JohmasJo/OptiDodge/PCB And Shell/OptiDodge_PCB/BOM_Board1_PCB1_2026-10-20.xlsx

Quantity | Designator | Footprint | Value | Manufacturer Part | Manufacturer | Supplier Part | Supplier
3 | C1,C3,C5 | C0603 | 100nF
2 | C2,C4 | C0603 | 10uF
4 | KEY1,KEY2,KEY3,KEY4 | SW-SMD_L3.9-W3.0-P4.45 |  | TS-1088-AR02016 | XUNPU(讯普) | C720477 | LCSC
1 | LED1 | LED0603-FD |  | GL0603UR01 | Guiguang light(桂光光电) | C51933292 | LCSC
1 | R1 | R0603 | 33
4 | R2,R3,R4,R5 | R0603 | 10K
1 | U1 | LED-TH_BD5.8-P2.54-R-RD |  | HSDL-4261 | LITEON(光宝) | C5175315 | LCSC
1 | U2 | DIP-8，非标错位直插，脚距 2.00 mm
1 | U3 | SOIC-8_L5.2-W5.2-P1.27-LS8.0-BL |  | W25Q64JVSSIM | Winbond(华邦) | C5362615 | LCSC
1 | U4 | CONN-TH_L53.3-W22.9_STM32F103C8T6-CARD |  | LCKFB-DKX-STM32F103C8T6 | 立创开发板 | C22396880 | LCSC
1 | U5 | HDR-TH_LAIL-PM2.54-6P-L |  | LAIL-PM2.54-6P-L | LAILAN(莱联) | C54973826 | LCSC
1 | U6 | PowerSource 8Pin
