JohmasJo/OptiDodge/PCB And Shell/OptiDodge.SLDPRT

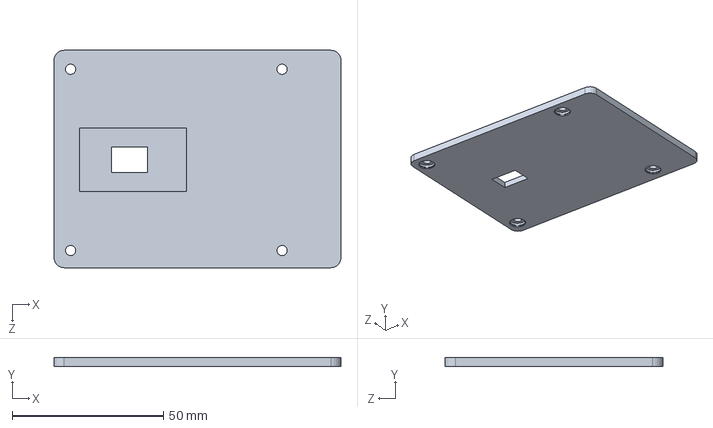
[picture p4: CAD file, 2026-10-26]
PCB And Shell/OptiDodge.SLDPRT
95.0 x 3.00 x 72.0 mm
