JohmasJo/OptiDodge/(list of files, cad)

Other CAD files:
PCB And Shell/OptiDodge.STL
