JohmasJo/OptiDodge/OptiDodge/Core/Inc/main.h

#define LED_TEST_Pin GPIO_PIN_1
#define LED_TEST_GPIO_Port GPIOA
#define OLED_RESET_Pin GPIO_PIN_2
#define OLED_RESET_GPIO_Port GPIOA
#define OLED_COMMAND_Pin GPIO_PIN_3
#define OLED_COMMAND_GPIO_Port GPIOA
#define PAW3327_NCS_Pin GPIO_PIN_8
#define PAW3327_NCS_GPIO_Port GPIOA
#define W25Q64_NCS_Pin GPIO_PIN_9
#define W25Q64_NCS_GPIO_Port GPIOA
#define MOUSE_MOTION_Pin GPIO_PIN_10
#define MOUSE_MOTION_GPIO_Port GPIOA
#define KEY1_Pin GPIO_PIN_3
#define KEY1_GPIO_Port GPIOB
#define KEY2_Pin GPIO_PIN_4
#define KEY2_GPIO_Port GPIOB
#define KEY3_Pin GPIO_PIN_5
#define KEY3_GPIO_Port GPIOB
#define KEY4_Pin GPIO_PIN_6
#define KEY4_GPIO_Port GPIOB
