JohmasJo/OptiDodge/OptiDodge/System/Game.c

//
// Created by wangy on 2026/10/24.
//

/* Includes */
#include "stm32f1xx_hal.h"
#include <stdlib.h>
#include "Draw.h"
#include "Game.h"
#include "Pattern.h"

/* Varieties */

/* Structure */

typedef struct {
    int8_t inward;   // 朝屏幕内部的速度，必须 > 0
    int8_t along;    // 沿出生边移动的速度
} Ball_Velocity;



/*
 * 每项都满足：
 * inward > 0
 * 1 <= inward² + along² <= 9
 */
static const Ball_Velocity Velocity_Table[] = {
    {1, -2}, {1, -1},
    {1,  0},
    {1,  1}, {1,  2},

    {2, -2}, {2, -1},
    {2,  0},
    {2,  1}, {2,  2},

    {3,  0}
};

/*enum*/
typedef enum{left, right, up, down} Side;


/* Functions*/
/**
 * @brief 输入小球和玩家信息，以计算是否会发生碰撞
 * @param ball 单个小球的结构体
 * @param player 玩家数据结构体
 * @return 玩家是否与小球碰撞
 */
uint8_t Collision_Detect(Ball* ball, Player* player) {
    if (!ball->isActive) {
        return CollisionFalse;
    }
    int8_t Ball_radius = Get_Ball_D() / 2;

    //计算初始的小球相对于玩家的坐标，以玩家为原点
    int16_t start_x = ball->x - player->player_x;
    int16_t start_y = ball->y - player->player_y;

    //计算小球在这一时间刻内相对于玩家移动的长度
    int16_t move_x = ball->x_velocity - player->player_delta_x;
    int16_t move_y = ball->y_velocity - player->player_delta_y;

    //计算两个物体间的最小允许距离：将两者的半径进行相加
    int16_t radius_sum = PLAYER_RADIUS + Ball_radius;
    //使用乘方来防止进行开方运算
    uint32_t min_distance_squared = (int32_t)radius_sum * radius_sum;
    uint32_t start_distance_squared = (int32_t)start_x * start_x + (int32_t)start_y * start_y;
    uint32_t move_distance_squared = (int32_t)move_x * move_x + (int32_t)move_y * move_y;
    
    if (start_distance_squared <= min_distance_squared) {
        return CollisionTrue;//当开始的时候距离已经小于最小距离，就说明已经碰上了，根本不用算
    }
    
    //此处为向量-OA·AB
    int32_t projection = - (((int32_t)start_x * move_x) + ((int32_t)start_y * move_y));

    //若结果为负数，则小球远离玩家，刚刚算的结果就是最近距离
    if (projection <= 0) {
        return CollisionFalse;
    }
    
    //若结果为正数，则小球先靠近玩家，要进一步计算最短距离
    //向量点积大于相对位移的模的平方 -> 末端未到达直线最靠近原点那一点，取末尾位置的距离判断
    if (projection >= move_distance_squared) {
        //计算小球的末尾位置
        int16_t end_x = start_x + move_x;
        int16_t end_y = start_y + move_y;

        uint32_t end_distance_squared = (int32_t)end_x * end_x + end_y * end_y;
        if (end_distance_squared <= min_distance_squared) {
            return CollisionTrue;
        }
        else {
            return CollisionFalse;
        }
    }

    //向量点积小于相对位移模的平方 -> 最短距离就是直线距离原点最近那一点
    else {
        /*
         *cross: (start_x, start_y)x(move_x, move_y)，使用矢量叉乘（行列式的几何意义）来计算2*面积
         *大小等效于移动距离乘上原点到直线距离，将其与最小距离和移动距离的乘积相比，比大小
         * 最终得到的结果就是点到直线距离和最小距离进行比较*/
        int64_t cross = (int64_t)start_x * move_y - (int64_t)start_y * move_x;
        if (cross * cross <= min_distance_squared * move_distance_squared) {
            return CollisionTrue;
        }
        else {
            return CollisionFalse;
        }
    }
}

/**
 * @brief 生成随机的X坐标
 * @return 随机的X坐标
 */
int16_t Random_Ball_X(void) {
    return rand() % (SCREEN_WIDTH + Get_Ball_D()) - Get_Ball_D();
}

/**
 * @brief 生成随机的Y坐标
 * @return 随机的Y坐标
 */
int16_t Random_Ball_Y(void) {
    return rand() % (SCREEN_HEIGHT + Get_Ball_D()) - Get_Ball_D();
}

/**
 * @brief 生产随机的小球出生边，为左右上下
 * @return 边
 */
Side Random_Side(void) {
    return (Side)(rand() % 4);
}

/**
 * @brief 根据小球所在的出生边，生成范围在2~5之间的预制整型速度
 * @param side 小球生成的边
 * @return对应的xy速度对
 */
int8_t* Random_Ball_XY_Velocity(Side side) {
    static int8_t Velocity[2];

    uint8_t Table_Count = sizeof(Velocity_Table) / sizeof(Velocity_Table[0]);
    uint8_t ran_index = rand() % Table_Count;

    int8_t inward = Velocity_Table[ran_index].inward;
    int8_t along = Velocity_Table[ran_index].along;

    // 根据出生边，把“向内、沿边”转换为 x、y 速度。
    switch (side) {
        case left:
            Velocity[0] = inward;
            Velocity[1] = along;
            break;

        case right:
            Velocity[0] = -inward;
            Velocity[1] = along;
            break;

        case up:
            Velocity[0] = along;
            Velocity[1] = inward;
            break;

        case down:
            Velocity[0] = along;
            Velocity[1] = -inward;
            break;

        default:
            return NULL;
    }

    return Velocity;
}

/**
 * @brief 创建一个新的小球并刷新小球的状态为Active
 * @param ball 单个小球对象
 * @return 返回是否生成成功
 */
uCreateOut Create_New_Ball(Ball* ball) {
    Side side = Random_Side();

    // 根据出生边确定一个坐标，
    // 另一个坐标沿这条边随机生成。
    switch (side) {
        case left:
            ball->x = 0;
            ball->y = Random_Ball_Y();
            break;

        case right:
            ball->x = SCREEN_WIDTH - 1;
            ball->y = Random_Ball_Y();
            break;

        case up:
            ball->x = Random_Ball_X();
            ball->y = 0;
            break;

        case down:
            ball->x = Random_Ball_X();
            ball->y = SCREEN_HEIGHT - 1;
            break;
    }

    int8_t* Velocity = Random_Ball_XY_Velocity(side);
    if (Velocity == NULL) {
        return CrFalse;
    }

    // 返回数组会在下次调用时被覆盖，因此立即复制。
    ball->x_velocity = Velocity[0];
    ball->y_velocity = Velocity[1];
    // 所有信息设置完成，再激活小球。
    ball->isActive = ACTIVE;
    return CrTrue;
}

uint8_t Update_Game(Gaming_Info *info) {
    uint8_t isGameOver = GameEndFalse;
    uint8_t i;
    for (i = 0; i < MAX_BALLS; i++)
    {
        if (info->ball[i].isActive == INACTIVE) {
            continue;
        }
        if (Collision_Detect(&info->ball[i],&info->player ) == CollisionTrue) {
            isGameOver = GameEndTrue;
        }
        info->ball[i].x += info->ball[i].x_velocity;
        info->ball[i].y += info->ball[i].y_velocity;
        if (info->ball[i].x > SCREEN_WIDTH
            || info->ball[i].x < 0
            || info->ball[i].y > SCREEN_HEIGHT
            || info->ball[i].y < 0) {
            info->ball[i].isActive = INACTIVE;
        }
    }
    info->player.player_x += info->player.player_delta_x;
    info->player.player_y += info->player.player_delta_y;
    info->score += 20;
    return isGameOver;
}
