JohmasJo/OptiDodge/OptiDodge/System/Pattern.h

//
// Created by wangy on 2026/10/22.
//

#ifndef OPTIDODGE_PATTERN_H
#define OPTIDODGE_PATTERN_H
#define BALL_WIDTH Get_Ball_D()
#define BALL_HEIGHT Get_Ball_D()
#define PLAYER_RADIUS 2
#define PLAYER_WIDTH 5
#define PLAYER_HEIGHT 5
#define SCREEN_WIDTH 128
#define SCREEN_HEIGHT 64
#define MAX_D_CIRCLE 20
#define MIN_D_CIRCLE 3
#define MAX_BALLS 20
#define OLED_PAGE_SIZE 8



#endif //OPTIDODGE_PATTERN_H
