JohmasJo/OptiDodge/OptiDodge/Hardware/Key.c

//
// Created by wangy on 2026/10/27.
//

#include "Key.h"
#include "main.h"
#include "FreeRTOS.h"
#include "task.h"

#define vTaskDelay(x) HAL_Delay(x)

Orientation Get_KeyNum(void) {
    if (HAL_GPIO_ReadPin(KEY1_GPIO_Port, KEY1_Pin) == GPIO_PIN_RESET) {
        vTaskDelay(20);
        if (HAL_GPIO_ReadPin(KEY1_GPIO_Port, KEY1_Pin) == GPIO_PIN_RESET) {
            while (HAL_GPIO_ReadPin(KEY1_GPIO_Port, KEY1_Pin) == GPIO_PIN_RESET) {
                vTaskDelay(5);//防止忙等
            }
            return down;
        }
    }
    else if (HAL_GPIO_ReadPin(KEY2_GPIO_Port, KEY2_Pin) == GPIO_PIN_RESET) {
        vTaskDelay(20);
        if (HAL_GPIO_ReadPin(KEY2_GPIO_Port, KEY2_Pin) == GPIO_PIN_RESET) {
            while (HAL_GPIO_ReadPin(KEY2_GPIO_Port, KEY2_Pin) == GPIO_PIN_RESET) {
                vTaskDelay(5);//防止忙等
            }
            return up;
        }
    }
    else if (HAL_GPIO_ReadPin(KEY3_GPIO_Port, KEY3_Pin) == GPIO_PIN_RESET) {
        vTaskDelay(20);
        if (HAL_GPIO_ReadPin(KEY3_GPIO_Port, KEY3_Pin) == GPIO_PIN_RESET) {
            while (HAL_GPIO_ReadPin(KEY3_GPIO_Port, KEY3_Pin) == GPIO_PIN_RESET) {
                vTaskDelay(5);//防止忙等
            }
            return right;
        }
    }
    else if (HAL_GPIO_ReadPin(KEY4_GPIO_Port, KEY4_Pin) == GPIO_PIN_RESET) {
        vTaskDelay(20);
        if (HAL_GPIO_ReadPin(KEY4_GPIO_Port, KEY4_Pin) == GPIO_PIN_RESET) {
            while (HAL_GPIO_ReadPin(KEY4_GPIO_Port, KEY4_Pin) == GPIO_PIN_RESET) {
                vTaskDelay(5);//防止忙等
            }
            return left;
        }
    }
    return Key_None;
}
