JohmasJo/OptiDodge/(commit log)

2026-10-26 Initial commit: set up STM32 project and OLED ball rendering
    - Set up the base project using STM32 HAL.
    - Integrate the OLED display driver.
    - Add a 128×64 canvas buffer for drawing.
    - Implement draw_Ball() to draw ball bitmaps onto the canvas.
    - Display the canvas on the OLED and update the ball position in the main loop.
    [BOM_Board1_PCB1_2026-10-20.xlsx, OptiDodge.SLDPRT, OptiDodge.STL, OptiDodge_pin.csv]
2026-10-26 - Created Collision_Detect function to detect collision between player and balls. - Set structure of balls, player and all information of game to well managing the game information and update data be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
    [Draw.c, Draw.h, Game.c, Game.h, Pattern.h]
2026-10-26 Import framework of FreeRTOS and created FreeRTOS_Program.c to write FreeRTOS codes.
    - Adding FreeRTOS framework.
    - Modify CubeMX generated codes including IT code changes and change IT priorities to enable HAL systick.
2026-10-26 - Create algorithm of new balls initialization, including speeds, positions and spawn points of balls. -Support set font size in real time. -Create and write all kinds of Score sorting, loading and s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
2026-10-27 - replace random() function to standard rand() function. - Add key detecting function to return pressed key. - Writed menu UIs and tested well in real PCB environment. - Solved W25Q64 chip unreached 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
    [Draw.c, Game.c, Key.c, Key.h, OptiDodge.ioc, Pattern.h]
2026-11-01 Implement optical-controlled gameplay and FreeRTOS task coordination.
    - Add PAW3327 driver with register macros, product ID checking, initialization and Motion Burst reading.
    - Connect optical motion to player movement, adjust axis directions and discard accumulated displacement when starting a game.
    - Apply software DPI scaling to player movement and change sensitivity options to 1200, 2400 and 4800.
    - Implement initialization, menu, game, drawing and ball creation tasks, with a 40ms game update timer.
    - Use queues to transfer new balls and game snapshots, and event groups to coordinate task shutdown after Game Over.
    - Reuse a one-shot timer for random ball spawning, with intervals of 100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
