JohmasJo/OptiDodge/(notices)

Notices in the files:
OptiDodge/Core/Inc/main.h:
Copyright (c) 2026 STMicroelectronics.
All rights reserved.
This software is licensed under terms that can be found in the LICENSE file
OptiDodge/Hardware/oled.h:
Copyright(C) ÖÐ¾°Ô°µç×Ó2014/3/16
